RepRapster/CW1_for_SB_TAP/Pic1.JPG

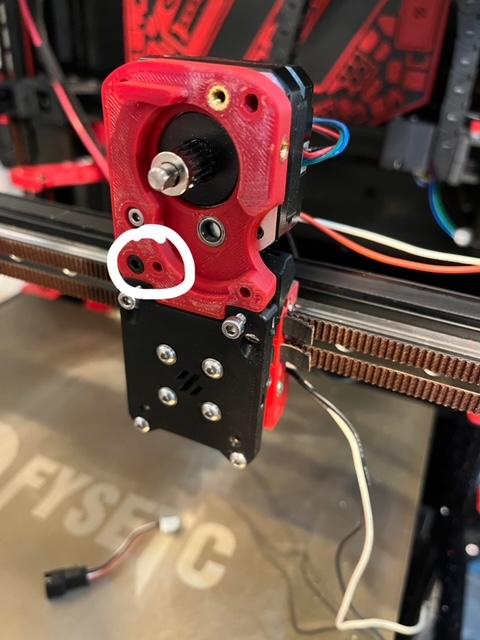
Pic1.JPG
