RepRapster/CW1_for_SB_TAP/SB_CW1_TAP.jpg

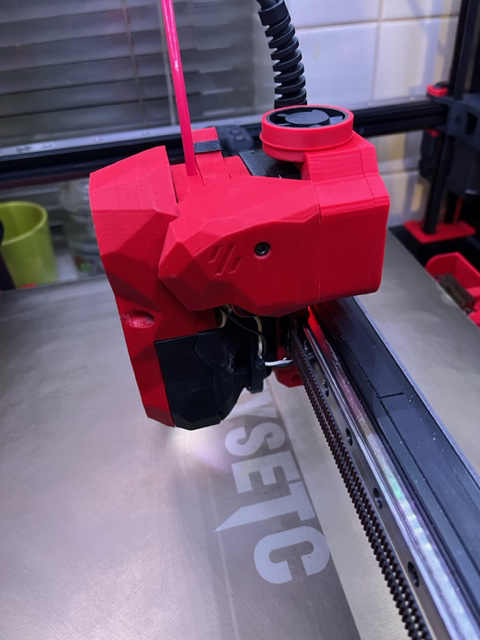
SB_CW1_TAP.jpg
