RepRapster/CW1_for_SB_TAP/Pic2.jpg

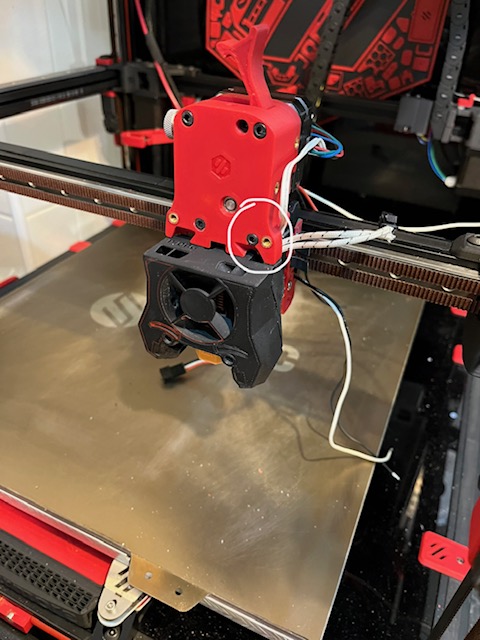
Pic2.jpg
