RepRapster/CW1_for_SB_TAP/Voron_TAP.jpg

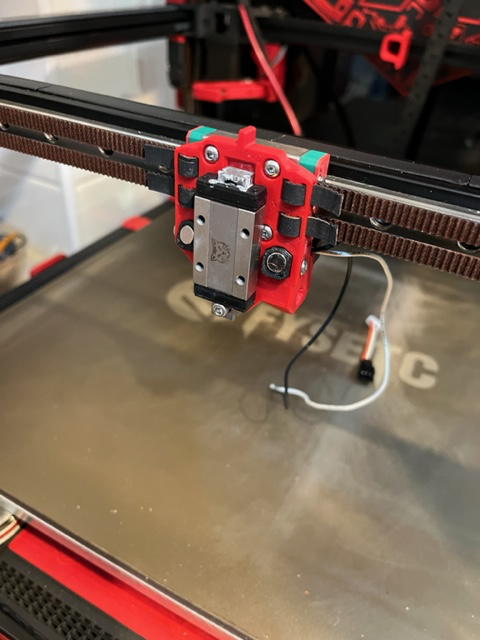
Voron_TAP.jpg
