RepRapster/CW1_for_SB_TAP/CW1_Tap_extruder_motor_plate.stl

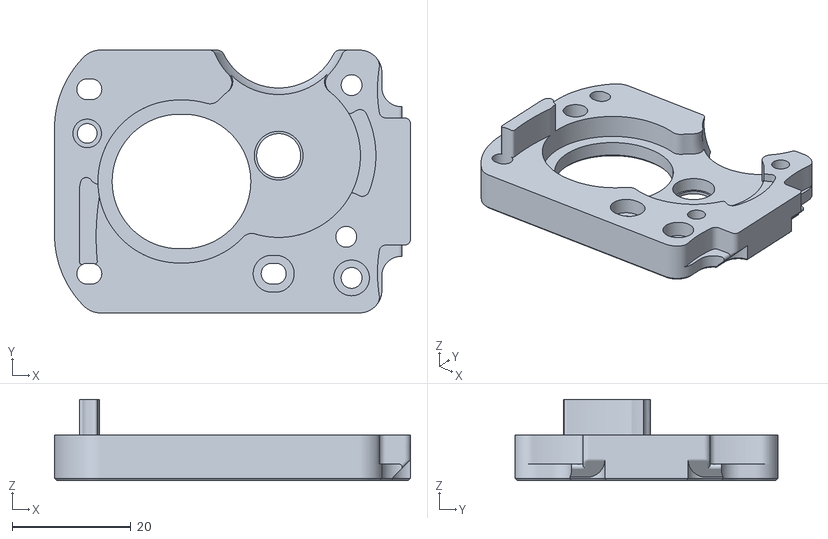
[picture p5: CAD file, 2023-02-15]
CW1_Tap_extruder_motor_plate.stl
59.9 x 44.2 x 13.7
