RepRapster/CW1_for_SB_TAP/CW1_Tap_Extruder_Body.stl

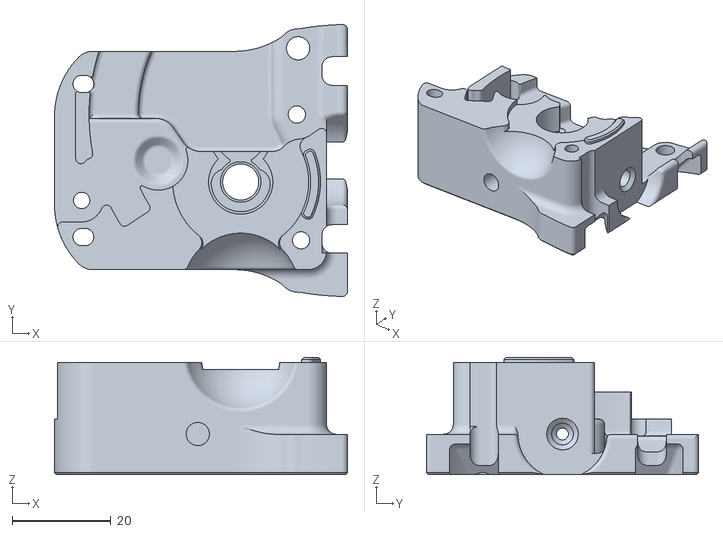
[picture p6: CAD file, 2023-02-15]
CW1_Tap_Extruder_Body.stl
59.3 x 55.0 x 23.7
