RepRapster/CW1_for_SB_TAP/(threads)

Thread 1 (2023-05-06):

CW1 TAP R8 issue?

ChrisWhite1985, 2023-05-06:
Hi there,

Got CW1 mounted on TAP R8 but doesn't seem to go back in position properly i.e. straight. Seen this before?

Thanks.

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
